mszkowalik/SamplingScope/Project Outputs for Sampling_Scope/BOM/BOM-Sampling_Scope(JLCPCB).xlsx

Part Number | Description | Designator | Quantity | Supplier 1 | Manufacturer 1 | Manufacturer Part Number 1 | Manufacturer Lifecycle 1 | Supplier Unit Price 1 | Supplier Subtotal 1 | Manufacturer | Manufacturer Part Number | Price | Revision State | Supplier Currency 1 | Supplier Order Qty 1 | Supplier Part Number 1 | Supplier Stock 1 | Supplier Subtotal per Board 1 | Footprint
C_1NF_50V_C0G_0402_5 | Ceramic Capacitor | C8_COMP_N, C8_COMP_P, C23_DELAY_DAC1, C23_DELAY_DAC2, C23_VREF_DAC1, C23_VREF_DAC2, C81_VREF_N, C81_VREF_P, C95 | 9 | Digi-Key | Taiyo Yuden | UMK105CG102JV-F | Not Recommended for New Design | 0.091 | 0.91 | Taiyo Yuden | UMK105CG102JV-F | 0.91 | Not managed | USD | 10 | 587-5484-6-ND | 7189 | 0.819 | C_0402_1005
C_1UF_25V_X5R_0402_10 | Ceramic Capacitor | C5_COMP_N, C5_COMP_P, C72, C108, C109 | 5 | Mouser | Samsung | CL05A105KA5NQNC | Volume Production | 0.089 | 0.89 | Samsung Electro-Mechanics | CL05A105KA5NQNC | 0.89 | Not managed | USD | 10 | 187-CL05A105KA5NQNC | 106632 | 0.445 | C_0402_1005
C_4U7F_10V_X5R_0402_20 | Ceramic Capacitor | C39, C40 | 2 | Mouser | Samsung | CL05A475MP5NRNC | Volume Production |  |  | Samsung Electro-Mechanics | CL05A475MP5NRNC |  | Not managed |  |  | 187-CL05A475MP5NRNC |  |  | C_0402_1005
C_10UF_25V_X5R_0805_10 | Ceramic Capacitor | C43, C44, C45_LDO_CMOS, C45_LDO_ECL, C46_LDO_CMOS, C46_LDO_ECL, C49_LDO_CMOS, C49_LDO_ECL, C50_LDO_CMOS, C50_LDO_ECL, C53, C58, C60, C61, C62, C63, C64, C67, C68, C69, C70, C71, C91, C92, C93, C110 | 26 | Mouser | Samsung | CL21A106KAYNNNE | Volume Production | 0.085 | 2.21 | Samsung Electro-Mechanics | CL21A106KAYNNNE | 2.21 | Not managed | USD | 26 | 187-CL21A106KAYNNNE | 1170 | 2.21 | C_0805_2012
C_22UF_25V_X5R_0805_20 | Ceramic Capacitor | C52, C55, C56, C57 | 4 | Mouser | Murata | GRM21BR61E226ME44K | Volume Production | 0.47 | 1.88 | Murata Electronics | GRM21BR61E226ME44K | 1.88 | Not managed | USD | 4 | 81-GRM21BR61E226ME4K | 326239 | 1.88 | C_0805_2012
C_100NF_16V_X5R_0402_10 | Ceramic Capacitor | C1, C2, C3, C4, C6_COMP_N, C6_COMP_P, C7_COMP_N, C7_COMP_P, C9_COMP_N, C9_COMP_P, C10_COMP_N, C10_COMP_P, C11_COMP_N, C11_COMP_P, C12_COMP_N, C12_COMP_P, C13_COMP_N, C13_COMP_P, C14_COMP_N, C14_COMP_P, C15_COMP_N, C15_COMP_P, C16_COMP_N, C16_COMP_P, C17_DELAY_DAC1, C17_DELAY_DAC2, C17_VREF_DAC1, C17_VREF_DAC2, C18_DELAY_DAC1, C18_DELAY_DAC2, C18_VREF_DAC1, C18_VREF_DAC2, C19_DELAY_DAC1, C19_DELAY_DAC2, C19_VREF_DAC1, C19_VREF_DAC2, C20_DELAY_DAC1, C20_DELAY_DAC2, C20_VREF_DAC1, C20_VREF_DAC2, C21_DELAY_DAC1, C21_DELAY_DAC2, C21_VREF_DAC1, C21_VREF_DAC2, C22_DELAY_DAC1, C22_DELAY_DAC2, C22_VREF_DAC1, C22_VREF_DAC2, C24, C25, C26, C27, C29, C30, C31, C32, C33, C34, C35, C36, C37, C47_LDO_CMOS, C47_LDO_ECL, C48_LDO_CMOS, C48_LDO_ECL, C51, C54, C59, C65, C66, C73, C74, C75, C76, C77_PROGRAMMABLE_DELAY_LINE_MAIN, C77_PROGRAMMABLE_DELAY_LINE_STEP_GEN, C78_PROGRAMMABLE_DELAY_LINE_MAIN, C78_PROGRAMMABLE_DELAY_LINE_STEP_GEN, C79_VREF_N, C79_VREF_P, C80_VREF_N, C80_VREF_P, C82, C83, C84, C85, C86, C87, C88, C89, C90, C94, C96, C97, C98, C99, C100, C101, C102, C103, C104, C105, C106, C107, C111, C112, C113, C114, C115, C116, C120, C130 | 112 | Mouser | Taiyo | EMK105BJ104KV-F | Unknown | 0.009 | 1.01 | Taiyo Yuden | EMK105BJ104KV-F | 1.01 | Not managed | USD | 112 | 963-EMK105BJ104KV-F | 2966120 | 1.01 | C_0402_1005
R_0R_0402_1 | Thick Film Resistor | R11_COMP_N, R11_COMP_P, R22, R25_LDO_CMOS, R25_LDO_ECL, R26_LDO_CMOS, R26_LDO_ECL, R44_PROGRAMMABLE_DELAY_LINE_MAIN, R44_PROGRAMMABLE_DELAY_LINE_STEP_GEN, R103 | 10 | Mouser | Yageo | RC0402FR-070RL | Volume Production | 0.01 | 0.1 | Yageo | RC0402FR-070RL | 0.1 | Not managed | USD | 10 | 603-RC0402FR-070RL | 142836 | 0.1 | R_0402_1005
R_0R_0805_1 | Thick Film Resistor | R107 | 1 | Mouser | Yageo | RC0805JR-070RL | Volume Production | 0.1 | 0.1 | Yageo | RC0805JR-070RL | 0.1 | Not managed | USD | 1 | 603-RC0805JR-070RL | 1148965 | 0.1 | R_0805_2012
R_1K5_0402_1 | Thick Film Resistor | R84 | 1 | Mouser | Yageo | RC0402FR-071K5L | Volume Production | 0.1 | 0.1 | Yageo | RC0402FR-071K5L | 0.1 | Not managed | USD | 1 | 603-RC0402FR-071K5L | 394688 | 0.1 | R_0402_1005
R_1K_0402_1 | Thick Film Resistor | R18_DELAY_DAC1, R18_DELAY_DAC2, R18_VREF_DAC1, R18_VREF_DAC2, R19_DELAY_DAC1, R19_DELAY_DAC2, R19_VREF_DAC1, R19_VREF_DAC2, R20_DELAY_DAC1, R20_DELAY_DAC2, R20_VREF_DAC1, R20_VREF_DAC2, R21, R101, R102 | 15 | Mouser | Yageo | RC0402FR-7D1KL | Unknown | 0.012 | 0.18 | Yageo | RC0402FR-7D1KL | 0.18 | Not managed | USD | 15 | 603-RC0402FR-7D1KL | 64382 | 0.18 | R_0402_1005
R_2K_0402_1 | Thick Film Resistor | R45_VREF_N, R45_VREF_P, R46_VREF_N, R46_VREF_P | 4 | Mouser | Yageo | RC0402FR-072KL | Volume Production | 0.012 | 0.12 | Yageo | RC0402FR-072KL | 0.12 | Not managed | USD | 10 | 603-RC0402FR-072KL | 687638 | 0.048 | R_0402_1005
R_4K7_0402_1 | Thick Film Resistor | R110, R111 | 2 | Mouser | Yageo | RC0402FR-7D4K7L | Unknown | 0.012 | 0.12 | Yageo | RC0402FR-7D4K7L | 0.12 | Not managed | USD | 10 | 603-RC0402FR-7D4K7L | 7750 | 0.024 | R_0402_1005
R_10K_0402_1 | Thick Film Resistor | R17_COMP_N, R17_COMP_P, R24, R39, R58, R63, R83, R86, R87, R88, R89, R90, R91, R92, R93, R108, R109_LDO_CMOS, R109_LDO_ECL | 18 | Mouser | Yageo | RC0402FR-7W10KL |  | 0.021 | 0.378 | Yageo | RC0402FR-7W10KL | 0.378 | Not managed | USD | 18 | 603-RC0402FR-7W10KL | 11405 | 0.378 | R_0402_1005
R_22K_0402_1 | Thick Film resistor | R100 | 1 | Mouser | Yageo | RC0402FR-0722KL | Volume Production | 0.1 | 0.1 | Yageo | RC0402FR-0722KL | 0.1 | Not managed | USD | 1 | 603-RC0402FR-0722KL | 201980 | 0.1 | R_0402_1005
R_33R_0402_1 | Thick Film Resistor | R56, R57, R59, R60, R65 | 5 | Mouser | Yageo | RC0402FR-0733RL | Volume Production | 0.014 | 0.14 | Yageo | RC0402FR-0733RL | 0.14 | Not managed | USD | 10 | 603-RC0402FR-0733RL | 1961173 | 0.07 | R_0402_1005
R_49R9_0402_1 | Thick Film Resistor | R66, R67, R68, R69, R70, R71, R72, R73, R74, R75, R76, R77, R78, R79, R80, R81, R82 | 17 | Mouser | Yageo | RC0402FR-0749R9L | Volume Production | 0.012 | 0.204 | Yageo | RC0402FR-0749R9L | 0.204 | Not managed | USD | 17 | 603-RC0402FR-0749R9L | 554069 | 0.204 | R_0402_1005
R_82R5_0402_1 | Thick Film Resistor | R3, R4, R8_COMP_N, R8_COMP_P, R9_COMP_N, R9_COMP_P, R10_COMP_N, R10_COMP_P, R15_COMP_N, R15_COMP_P, R16_COMP_N, R16_COMP_P, R32, R37, R38, R42_PROGRAMMABLE_DELAY_LINE_MAIN, R42_PROGRAMMABLE_DELAY_LINE_STEP_GEN, R43_PROGRAMMABLE_DELAY_LINE_MAIN, R43_PROGRAMMABLE_DELAY_LINE_STEP_GEN, R52, R53, R54, R55, R96, R97 | 25 | Mouser | Yageo | RC0402FR-0782R5L | Volume Production | 0.014 | 0.35 | Yageo | RC0402FR-0782R5L | 0.35 | Not managed | USD | 25 | 603-RC0402FR-0782R5L | 14880 | 0.35 | R_0402_1005
R_100K_0402_1 | Thick Film Resistor | R28, R85, R98, R104, R105, R106 | 6 | Mouser | Yageo | RC0402FR-07100KL | Volume Production | 0.012 | 0.12 | Yageo | RC0402FR-07100KL | 0.12 | Not managed | USD | 10 | 603-RC0402FR-07100KL | 1854795 | 0.072 | R_0402_1005
R_100R_0402_1 | Thick Film Resistor | R23, R99 | 2 | Mouser | Yageo | RC0402FR-13100RL | Volume Production | 0.012 | 0.12 | Yageo | RC0402FR-13100RL | 0.12 | Not managed | USD | 10 | 603-RC0402FR-13100RL | 521264 | 0.024 | R_0402_1005
R_127R_0402_1 | Thick Film Resistor | R1, R2, R5_COMP_N, R5_COMP_P, R6_COMP_N, R6_COMP_P, R7_COMP_N, R7_COMP_P, R12_COMP_N, R12_COMP_P, R13_COMP_N, R13_COMP_P, R31, R35, R36, R40_PROGRAMMABLE_DELAY_LINE_MAIN, R40_PROGRAMMABLE_DELAY_LINE_STEP_GEN, R41_PROGRAMMABLE_DELAY_LINE_MAIN, R41_PROGRAMMABLE_DELAY_LINE_STEP_GEN, R48, R49, R50, R51, R94, R95 | 25 | Mouser | Yageo | RC0402FR-07127RL | Volume Production | 0.016 | 0.4 | Yageo | RC0402FR-07127RL | 0.4 | Not managed | USD | 25 | 603-RC0402FR-07127RL | 29867 | 0.4 | R_0402_1005
R_150R_0402_1 | Thick Film Resistor | R61, R62, R64 | 3 | Mouser | Yageo | RC0402FR-07150RL | Volume Production | 0.012 | 0.12 | Yageo | RC0402FR-07150RL | 0.12 | Not managed | USD | 10 | 603-RC0402FR-07150RL | 397690 | 0.036 | R_0402_1005
R_200K_0402_1 | Thick Film Resistor | R27 | 1 | Mouser | Yageo | RC0402FR-07200KL | Volume Production | 0.1 | 0.1 | Yageo | RC0402FR-07200KL | 0.1 | Not managed | USD | 1 | 603-RC0402FR-07200KL | 706297 | 0.1 | R_0402_1005
