mszkowalik/SamplingScope/Project Outputs for Sampling_Scope/BOM/BOM-Sampling_Scope(NO JLCPCB).xlsx

Part Number | Description | Designator | Sample | Quantity | Manufacturer 1 | Manufacturer Part Number 1 | Supplier 1 | Supplier Part Number 1 | Supplier Unit Price 1 | Supplier Subtotal 1
744231091 | Common Mode Line Filter | L8 | 0 | 1
60312202111527 | SMA Connector | CLK_OUT1, COMP_IN_N1, COMP_IN_P1, DUT_N1, DUT_P1, SNS_N1, SNS_P1, TRIGGER1 | 0 | 8
ADCMP582BCPZ-RL7 | Single Comparator | U4_COMP_N, U4_COMP_P, U15 | 2 | 3
PS1608GT2-R50-T1 | 20GHz Resistive Power Splitter | PS1, PS2 | 0 | 2
632723100011 | WR-COM USB 3.1 Type C Receptacle Horizontal THT / SMT | J3 | 0 | 1
SN74AHC1G04DBVR | Inverters Single | U7_COMP_N, U7_COMP_P, U10, U24 | 5 | 4
EVQ-P7J01P | Tact Switch | S1 | 0 | 1 | Panasonic | EVQ-P7J01P | Digi-Key | P16767CT-ND | 0.28 | 0.28
74HC4040BQX | 12 bit binary ripple counter | U23 | 0 | 1 | NXP Semiconductors | 74HC4040BQX | Mouser | 771-74HC4040BQX | 0.51 | 0.51
74LVC1G17SE-7 | Schmitt Buffer | U3 | 0 | 1 | Diodes | 74LVC1G17SE-7 | Mouser | 621-74LVC1G17SE-7 | 0.27 | 0.27
74LVC1G79GV,125 | D Flip Flop Positive Edge Trigger | U6_COMP_N, U6_COMP_P | 0 | 2 | Nexperia | 74LVC1G79GV,125 | Mouser | 771-LVC1G79GV125 | 0.38 | 0.76
74LVC161PW,112 | 4 bit Counter with preset | U22 | 0 | 1 | NXP Semiconductors | 74LVC161PW112 | Mouser | 771-LVC161PW112
1239AS-H-4R7M=P2 | Power Inductor | L1, L2, L4, L5, L6, L7 | 0 | 6 | Murata | 1239AS-H-4R7M=P2 | Mouser | 81-1239AS-H-4R7MP2 | 0.43 | 2.58
C_8P2F_50V_C0G_0402_3 | Ceramic Capacitor | C41, C42 | 0 | 2 | Taiyo Yuden | UMK105CG8R2DV-F | Mouser | 963-UMK105CG8R2DV-F | 0.016 | 0.16
DRV8850RGYR | Low Voltage H-Bridge IC With LDO Voltage Regulator | U25 | 5 | 1 | Texas Instruments | DRV8850RGYR | Mouser | 595-DRV8850RGYR | 1.61 | 1.61
ESDA25P35-1U1M | High power transient voltage suppressor | D2 | 0 | 1 | STMicroelectronics | ESDA25P35-1U1M | Mouser | 511-ESDA25P35-1U1M | 0.45 | 0.45
ESDA25W | TVS DIODE 24VWM SOT23 | D3 | 0 | 1 | STMicroelectronics | ESDA25W | Mouser | 511-ESDA25W | 0.42 | 0.42
FBMJ1608HS220NTR | Ferrite Bead | FB2, FB3 | 0 | 2 | Taiyo Yuden | FBMJ1608HS220NTR | Mouser | 963-FBMJ1608HS220NTR | 0.1 | 0.2
FTSH-105-01-L-DV-K-TR | CONN HEADER SMD 10POS 1.27MM | STM1 | 0 | 1 | Samtec | FTSH-105-01-L-DV-K-TR | Mouser | 200-FTSH10501LDVKTR | 3 | 3
MC100EPT21MNR4G | Differential LVPECL/LVDS/CML to LVTTL/LVCMOS Translator | U2, U5_COMP_N, U5_COMP_P | 0 | 3 | ON Semiconductor | MC100EPT21MNR4G | Mouser | 863-MC100EPT21MNR4G | 10.08 | 30.24
MC100LVELT20DG | LVTTL/LVCMOS to Differential LVPECL Translator | U1 | 0 | 1 | ON Semiconductor | MC100LVELT20DG | Mouser | 863-MC100LVELT20DG | 4.63 | 4.63
MCP1501-20E/SN | 2.048V Voltage References Precision Buffered Voltage Reference | U8_DELAY_DAC1, U8_DELAY_DAC2, U8_VREF_DAC1, U8_VREF_DAC2 | 3 | 4 | Microchip | MCP1501-20E/SN | Mouser | 579-MCP1501-20E/SN | 0.82 | 3.28
MCP4921-E/SN | 1 Channel DAC 12 bit | U9_DELAY_DAC1, U9_DELAY_DAC2, U9_VREF_DAC1, U9_VREF_DAC2 | 4 | 4 | Microchip | MCP4921-E/SN | Mouser | 579-MCP4921-E/SN | 2.07 | 8.28
MLZ2012M2R2HT000 | Ferrite Bead | FB1 | 0 | 1 | TDK | MLZ2012M2R2HT000 | Mouser | 810-MLZ2012M2R2HT000 | 0.14 | 0.14
NCP15XH103J03RC | NTC Thermistor | RT1, RT2, RT3, RT4 | 0 | 4 | Murata | NCP15XH103J03RC | Mouser | 81-NCP15XH103J03RC | 0.1 | 0.4
NCV8705MT33TCG | Low Dropout, Ultra-Low Iq, High PSRR, Ultra-Low Noise 3.3V | U12_LDO_CMOS, U12_LDO_ECL, U13_LDO_CMOS, U13_LDO_ECL | 0 | 4 | ON Semiconductor | NCV8705MT33TCG | Mouser | 863-NCV8705MT33TCG | 1.35 | 5.4
OPA197IDR | Single Precision Rail-to-Rail Input Outpu Low Offset Voltage Op Amp | U17_VREF_N, U17_VREF_P | 5 | 2 | Texas Instruments | OPA197IDR | Mouser | 595-OPA197IDR | 1.65 | 3.3
R_18K7_0402_1 | Thick Film Resistor | R30 | 0 | 1 | Yageo | RC0402FR-0718K7L | Mouser | 603-RC0402FR-0718K7L | 0.1 | 0.1
R_24R9_0402_1 | Thick Film Resistor | R14_COMP_N, R14_COMP_P | 0 | 2 | Yageo | RC0402FR-0724R9L | Mouser | 603-RC0402FR-0724R9L | 0.014 | 0.14
R_30K_0402_1 | Thick Film Resistor | R29 | 0 | 1 | Yageo | RC0402FR-0730KL | Mouser | 603-RC0402FR-0730KL | 0.1 | 0.1
R_82K_0402_1 | Thisk Film Resistor | R47_VREF_N, R47_VREF_P | 0 | 2 | Yageo | RC0402FR-0782KL | Mouser | 603-RC0402FR-0782KL | 0.012 | 0.12
R_750R_0402_1 | Thick Film Resistor | R33, R34 | 0 | 2 | Yageo | RC0402FR-07750RL | Mouser | 603-RC0402FR-07750RL | 0.012 | 0.12
Si53360-B-GT | Low Jitter Clock Buffer | U20, U21 | 2 | 2 | Silicon Labs | SI53360-B-GT | Mouser | 634-SI53360-B-GT | 1.38 | 2.76
SMAJ5.0A-13-F | ESD Suppressors / TVS Diodes | D1 | 0 | 1 | Diodes | SMAJ5.0A-13-F | Mouser | 621-SMAJ5.0A-13-F | 0.39 | 0.39
STL6P3LLH6 | P-MOSFET 30V 6A 24mOhm | Q2, Q3 | 0 | 2 | STMicroelectronics | STL6P3LLH6 | Mouser | 511-STL6P3LLH6 | 0.99 | 1.98
STM32H733ZGT6 | MCU, 32 Bit, Cortex M7 RISC 1MB Flash 144 LQFP | U28 | 0 | 1 | STMicroelectronics | STM32H733ZGT6 | Mouser | 511-STM32H733ZGT6
STUSB4500QTR | Standalone USB PD controller for power sinking devices | U27 | 0 | 1 | STMicroelectronics | STUSB4500QTR | Mouser | 511-STUSB4500QTR | 2.25 | 2.25
SY10EP11UZG | 1:2 PECL Fanout Buffer | U18, U19, U26 | 0 | 3 | Microchip | SY10EP11UZG | Mouser | 998-SY10EP11UZG | 4.91 | 14.73
SY89296UMG | Delay Lines/Timing Elements 2.5V/3.3V PECL Delay Line | U16_PROGRAMMABLE_DELAY_LINE_MAIN, U16_PROGRAMMABLE_DELAY_LINE_STEP_GEN | 0 | 2 | Microchip | SY89296UMG | Mouser | 998-SY89296UMG | 11.48 | 22.96
TPD1E05U06DPYR | 1 Channel ESD Protection Device for Super-Speed (Up to 6 Gbps) | D4, D5 | 0 | 2 | Texas Instruments | TPD1E05U06DPYR | Mouser | 595-TPD1E05U06DPYR | 0.49 | 0.98
TPD4E05U06DQAR | ESD Suppressors / TVS Diodes 4Chnl U-Lo Capacitnc IEC ESD Prot Diodes | U11 | 0 | 1 | Texas Instruments | TPD4E05U06DQAR | Mouser | 595-TPD4E05U06DQAR | 0.65 | 0.65
TPS54308DDCR | FCCM SYNCHRONOUS STEP DOWN CONVE | U14 | 5 | 1 | Texas Instruments | TPS54308DDCR | Mouser | 595-TPS54308DDCR | 1.68 | 1.68
TPS65133DPDR | Split-Rail Converter, ±5V, 250mA Dual Output Power Supply | Q1 | 5 | 1 | Texas Instruments | TPS65133DPDR | Mouser | 595-TPS65133DPDR | 2.61 | 2.61
TSX-3225 24.0000MF20G-AC | Resonator Ceramic | XT1 | 0 | 1 | Epson | TSX-322524.0000MF20G-AC0 | Mouser | 732-322524F20GAC0 | 0.34 | 0.34
74438357056 | Power Inductor | L3 | 0 | 1 |  |  | Wurth electronics | 74438357056
691101710002 | PCB Terminal Block 1x2 | J2 | 0 | 1 |  |  | Wurth Elektronik | 691101710002
