mszkowalik/SamplingScope/Project Outputs for Sampling_Scope/BOM/JLCPCB_BOM-Sampling_Scope(JLCPCB).xlsx

Part Number | Description | Designator | Footprint | Manufacturer 2 | Manufacturer Part Number 2 | Supplier 2 | Supplier Part Number 2
R_4K7_0402_1 | Thick Film Resistor | R111 | R_0402_1005
R_4K7_0402_1 | Thick Film Resistor | R110 | R_0402_1005
R_10K_0402_1 | Thick Film Resistor | R109_LDO_ECL | R_0402_1005 | Uniroyal Elec | 0402WGF1002TCE | LCSC | C25744
R_10K_0402_1 | Thick Film Resistor | R109_LDO_CMOS | R_0402_1005 | Uniroyal Elec | 0402WGF1002TCE | LCSC | C25744
R_10K_0402_1 | Thick Film Resistor | R108 | R_0402_1005 | Uniroyal Elec | 0402WGF1002TCE | LCSC | C25744
R_0R_0805_1 | Thick Film Resistor | R107 | R_0805_2012 | Uniroyal Elec | 0805W8F0000T5E | LCSC | C17477
R_100K_0402_1 | Thick Film Resistor | R106 | R_0402_1005 | Uniroyal Elec | 0402WGF1003TCE | LCSC | C25741
R_100K_0402_1 | Thick Film Resistor | R105 | R_0402_1005 | Uniroyal Elec | 0402WGF1003TCE | LCSC | C25741
R_100K_0402_1 | Thick Film Resistor | R104 | R_0402_1005 | Uniroyal Elec | 0402WGF1003TCE | LCSC | C25741
R_0R_0402_1 | Thick Film Resistor | R103 | R_0402_1005 | Uniroyal Elec | 0402WGF0000TCE | LCSC | C17168
R_1K_0402_1 | Thick Film Resistor | R102 | R_0402_1005 | Uniroyal Elec | 0402WGF1001TCE | LCSC | C11702
R_1K_0402_1 | Thick Film Resistor | R101 | R_0402_1005 | Uniroyal Elec | 0402WGF1001TCE | LCSC | C11702
R_22K_0402_1 | Thick Film resistor | R100 | R_0402_1005 | Uniroyal Elec | 0402WGF2202TCE | LCSC | C25768
R_100R_0402_1 | Thick Film Resistor | R99 | R_0402_1005 | Uniroyal Elec | 0402WGF1000TCE | LCSC | C25076
R_100K_0402_1 | Thick Film Resistor | R98 | R_0402_1005 | Uniroyal Elec | 0402WGF1003TCE | LCSC | C25741
R_82R5_0402_1 | Thick Film Resistor | R97 | R_0402_1005 | Uniroyal Elec | 0402WGF825JTCE | LCSC | C52037
R_82R5_0402_1 | Thick Film Resistor | R96 | R_0402_1005 | Uniroyal Elec | 0402WGF825JTCE | LCSC | C52037
R_127R_0402_1 | Thick Film Resistor | R95 | R_0402_1005 | Uniroyal Elec | 0402WGF1270TCE | LCSC | C247127
R_127R_0402_1 | Thick Film Resistor | R94 | R_0402_1005 | Uniroyal Elec | 0402WGF1270TCE | LCSC | C247127
R_10K_0402_1 | Thick Film Resistor | R93 | R_0402_1005 | Uniroyal Elec | 0402WGF1002TCE | LCSC | C25744
R_10K_0402_1 | Thick Film Resistor | R92 | R_0402_1005 | Uniroyal Elec | 0402WGF1002TCE | LCSC | C25744
R_10K_0402_1 | Thick Film Resistor | R91 | R_0402_1005 | Uniroyal Elec | 0402WGF1002TCE | LCSC | C25744
R_10K_0402_1 | Thick Film Resistor | R90 | R_0402_1005 | Uniroyal Elec | 0402WGF1002TCE | LCSC | C25744
R_10K_0402_1 | Thick Film Resistor | R89 | R_0402_1005 | Uniroyal Elec | 0402WGF1002TCE | LCSC | C25744
R_10K_0402_1 | Thick Film Resistor | R88 | R_0402_1005 | Uniroyal Elec | 0402WGF1002TCE | LCSC | C25744
R_10K_0402_1 | Thick Film Resistor | R87 | R_0402_1005 | Uniroyal Elec | 0402WGF1002TCE | LCSC | C25744
R_10K_0402_1 | Thick Film Resistor | R86 | R_0402_1005 | Uniroyal Elec | 0402WGF1002TCE | LCSC | C25744
R_100K_0402_1 | Thick Film Resistor | R85 | R_0402_1005 | Uniroyal Elec | 0402WGF1003TCE | LCSC | C25741
R_1K5_0402_1 | Thick Film Resistor | R84 | R_0402_1005 | Uniroyal Elec | 0402WGF1501TCE | LCSC | C25867
R_10K_0402_1 | Thick Film Resistor | R83 | R_0402_1005 | Uniroyal Elec | 0402WGF1002TCE | LCSC | C25744
R_49R9_0402_1 | Thick Film Resistor | R82 | R_0402_1005 | Uniroyal Elec | 0402WGF499JTCE | LCSC | C25120
R_49R9_0402_1 | Thick Film Resistor | R81 | R_0402_1005 | Uniroyal Elec | 0402WGF499JTCE | LCSC | C25120
R_49R9_0402_1 | Thick Film Resistor | R80 | R_0402_1005 | Uniroyal Elec | 0402WGF499JTCE | LCSC | C25120
R_49R9_0402_1 | Thick Film Resistor | R79 | R_0402_1005 | Uniroyal Elec | 0402WGF499JTCE | LCSC | C25120
R_49R9_0402_1 | Thick Film Resistor | R78 | R_0402_1005 | Uniroyal Elec | 0402WGF499JTCE | LCSC | C25120
R_49R9_0402_1 | Thick Film Resistor | R77 | R_0402_1005 | Uniroyal Elec | 0402WGF499JTCE | LCSC | C25120
R_49R9_0402_1 | Thick Film Resistor | R76 | R_0402_1005 | Uniroyal Elec | 0402WGF499JTCE | LCSC | C25120
R_49R9_0402_1 | Thick Film Resistor | R75 | R_0402_1005 | Uniroyal Elec | 0402WGF499JTCE | LCSC | C25120
R_49R9_0402_1 | Thick Film Resistor | R74 | R_0402_1005 | Uniroyal Elec | 0402WGF499JTCE | LCSC | C25120
R_49R9_0402_1 | Thick Film Resistor | R73 | R_0402_1005 | Uniroyal Elec | 0402WGF499JTCE | LCSC | C25120
R_49R9_0402_1 | Thick Film Resistor | R72 | R_0402_1005 | Uniroyal Elec | 0402WGF499JTCE | LCSC | C25120
R_49R9_0402_1 | Thick Film Resistor | R71 | R_0402_1005 | Uniroyal Elec | 0402WGF499JTCE | LCSC | C25120
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
C_100NF_16V_X5R_0402_10 | Ceramic Capacitor | C97 | C_0402_1005 | Samsung Electro-Mechanics | CL05B104KO5NNNC | LCSC | C1525
C_100NF_16V_X5R_0402_10 | Ceramic Capacitor | C96 | C_0402_1005 | Samsung Electro-Mechanics | CL05B104KO5NNNC | LCSC | C1525
C_1NF_50V_C0G_0402_5 | Ceramic Capacitor | C95 | C_0402_1005 | Guangdong Fenghua Advanced Tech | 0402B102K500NT | LCSC | C1523
C_100NF_16V_X5R_0402_10 | Ceramic Capacitor | C94 | C_0402_1005 | Samsung Electro-Mechanics | CL05B104KO5NNNC | LCSC | C1525
C_10UF_25V_X5R_0805_10 | Ceramic Capacitor | C93 | C_0805_2012 | Samsung Electro-Mechanics | CL21A106KAYNNNE | LCSC | C15850
C_10UF_25V_X5R_0805_10 | Ceramic Capacitor | C92 | C_0805_2012 | Samsung Electro-Mechanics | CL21A106KAYNNNE | LCSC | C15850
C_10UF_25V_X5R_0805_10 | Ceramic Capacitor | C91 | C_0805_2012 | Samsung Electro-Mechanics | CL21A106KAYNNNE | LCSC | C15850
C_100NF_16V_X5R_0402_10 | Ceramic Capacitor | C90 | C_0402_1005 | Samsung Electro-Mechanics | CL05B104KO5NNNC | LCSC | C1525
C_100NF_16V_X5R_0402_10 | Ceramic Capacitor | C89 | C_0402_1005 | Samsung Electro-Mechanics | CL05B104KO5NNNC | LCSC | C1525
C_100NF_16V_X5R_0402_10 | Ceramic Capacitor | C88 | C_0402_1005 | Samsung Electro-Mechanics | CL05B104KO5NNNC | LCSC | C1525
C_100NF_16V_X5R_0402_10 | Ceramic Capacitor | C87 | C_0402_1005 | Samsung Electro-Mechanics | CL05B104KO5NNNC | LCSC | C1525
C_100NF_16V_X5R_0402_10 | Ceramic Capacitor | C86 | C_0402_1005 | Samsung Electro-Mechanics | CL05B104KO5NNNC | LCSC | C1525
C_100NF_16V_X5R_0402_10 | Ceramic Capacitor | C85 | C_0402_1005 | Samsung Electro-Mechanics | CL05B104KO5NNNC | LCSC | C1525
C_100NF_16V_X5R_0402_10 | Ceramic Capacitor | C84 | C_0402_1005 | Samsung Electro-Mechanics | CL05B104KO5NNNC | LCSC | C1525
C_100NF_16V_X5R_0402_10 | Ceramic Capacitor | C83 | C_0402_1005 | Samsung Electro-Mechanics | CL05B104KO5NNNC | LCSC | C1525
C_100NF_16V_X5R_0402_10 | Ceramic Capacitor | C82 | C_0402_1005 | Samsung Electro-Mechanics | CL05B104KO5NNNC | LCSC | C1525
C_1NF_50V_C0G_0402_5 | Ceramic Capacitor | C81_VREF_P | C_0402_1005 | Guangdong Fenghua Advanced Tech | 0402B102K500NT | LCSC | C1523
C_1NF_50V_C0G_0402_5 | Ceramic Capacitor | C81_VREF_N | C_0402_1005 | Guangdong Fenghua Advanced Tech | 0402B102K500NT | LCSC | C1523
C_100NF_16V_X5R_0402_10 | Ceramic Capacitor | C80_VREF_P | C_0402_1005 | Samsung Electro-Mechanics | CL05B104KO5NNNC | LCSC | C1525
C_100NF_16V_X5R_0402_10 | Ceramic Capacitor | C80_VREF_N | C_0402_1005 | Samsung Electro-Mechanics | CL05B104KO5NNNC | LCSC | C1525
C_100NF_16V_X5R_0402_10 | Ceramic Capacitor | C79_VREF_P | C_0402_1005 | Samsung Electro-Mechanics | CL05B104KO5NNNC | LCSC | C1525
C_100NF_16V_X5R_0402_10 | Ceramic Capacitor | C79_VREF_N | C_0402_1005 | Samsung Electro-Mechanics | CL05B104KO5NNNC | LCSC | C1525
C_100NF_16V_X5R_0402_10 | Ceramic Capacitor | C78_PROGRAMMABLE_DELAY_LINE_STEP_GEN | C_0402_1005 | Samsung Electro-Mechanics | CL05B104KO5NNNC | LCSC | C1525
C_100NF_16V_X5R_0402_10 | Ceramic Capacitor | C78_PROGRAMMABLE_DELAY_LINE_MAIN | C_0402_1005 | Samsung Electro-Mechanics | CL05B104KO5NNNC | LCSC | C1525
C_100NF_16V_X5R_0402_10 | Ceramic Capacitor | C77_PROGRAMMABLE_DELAY_LINE_STEP_GEN | C_0402_1005 | Samsung Electro-Mechanics | CL05B104KO5NNNC | LCSC | C1525
C_100NF_16V_X5R_0402_10 | Ceramic Capacitor | C77_PROGRAMMABLE_DELAY_LINE_MAIN | C_0402_1005 | Samsung Electro-Mechanics | CL05B104KO5NNNC | LCSC | C1525
C_100NF_16V_X5R_0402_10 | Ceramic Capacitor | C76 | C_0402_1005 | Samsung Electro-Mechanics | CL05B104KO5NNNC | LCSC | C1525
C_100NF_16V_X5R_0402_10 | Ceramic Capacitor | C75 | C_0402_1005 | Samsung Electro-Mechanics | CL05B104KO5NNNC | LCSC | C1525
C_100NF_16V_X5R_0402_10 | Ceramic Capacitor | C74 | C_0402_1005 | Samsung Electro-Mechanics | CL05B104KO5NNNC | LCSC | C1525
C_100NF_16V_X5R_0402_10 | Ceramic Capacitor | C73 | C_0402_1005 | Samsung Electro-Mechanics | CL05B104KO5NNNC | LCSC | C1525
C_1UF_25V_X5R_0402_10 | Ceramic Capacitor | C72 | C_0402_1005 | Samsung Electro-Mechanics | CL05A105KA5NQNC | LCSC | C52923
C_10UF_25V_X5R_0805_10 | Ceramic Capacitor | C71 | C_0805_2012 | Samsung Electro-Mechanics | CL21A106KAYNNNE | LCSC | C15850
C_10UF_25V_X5R_0805_10 | Ceramic Capacitor | C70 | C_0805_2012 | Samsung Electro-Mechanics | CL21A106KAYNNNE | LCSC | C15850
C_10UF_25V_X5R_0805_10 | Ceramic Capacitor | C69 | C_0805_2012 | Samsung Electro-Mechanics | CL21A106KAYNNNE | LCSC | C15850
C_10UF_25V_X5R_0805_10 | Ceramic Capacitor | C68 | C_0805_2012 | Samsung Electro-Mechanics | CL21A106KAYNNNE | LCSC | C15850
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
C_100NF_16V_X5R_0402_10 | Ceramic Capacitor | C2 | C_0402_1005 | Samsung Electro-Mechanics | CL05B104KO5NNNC | LCSC | C1525
C_100NF_16V_X5R_0402_10 | Ceramic Capacitor | C1 | C_0402_1005 | Samsung Electro-Mechanics | CL05B104KO5NNNC | LCSC | C1525
