mszkowalik/SamplingScope/Measurements/DAC_Delay.csv

8 | 1.949320882488340000E-08
16 | 1.949267414147470000E-08
24 | 1.949220873598280000E-08
32 | 1.949158345837530000E-08
40 | 1.949083916485960000E-08
48 | 1.949042705007290000E-08
56 | 1.949026895431420000E-08
64 | 1.949002026435660000E-08
72 | 1.948476402446890000E-08
80 | 1.948810179897010000E-08
88 | 1.948796857220710000E-08
96 | 1.948696137787920000E-08
104 | 1.948627392778230000E-08
112 | 1.948552608155300000E-08
120 | 1.948494698922330000E-08
128 | 1.948391137318590000E-08
136 | 1.948298589127260000E-08
144 | 1.947883099262530000E-08
152 | 1.948223093961590000E-08
160 | 1.948169270349350000E-08
168 | 1.948110828209340000E-08
176 | 1.948063577117410000E-08
184 | 1.948011529862010000E-08
192 | 1.947947936287160000E-08
200 | 1.947907080079860000E-08
208 | 1.947821282044520000E-08
216 | 1.947742944707900000E-08
224 | 1.947443273309090000E-08
232 | 1.947599592710960000E-08
240 | 1.947541150570940000E-08
248 | 1.947465122498220000E-08
256 | 1.947406325086830000E-08
264 | 1.947364758336790000E-08
272 | 1.947280559022600000E-08
280 | 1.947224248510790000E-08
288 | 1.947199557150730000E-08
296 | 1.947179484318440000E-08
304 | 1.947073080543760000E-08
312 | 1.946863648072390000E-08
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
