mszkowalik/SamplingScope/Measurements/DAC_Delay.xlsx

Sheet: _Com COM10_ (2021-04-30_232414)
Column1.1 | Column1.3 | Column1.5 | Column1.6 | Column1.7 | Column1.8 | Column1.9 | Column1.10 | Column1.11 | Column1.12 | Column1.13
0 |  |  |  |  |  |  |  | 1.946624906e-08
8 | 1.948500028e-08 | 1.948591155e-08 | 1.949360851e-08 | 1.949171669e-08 | 1.946677486e-08 | 1.949320882e-08 | 1.946306405e-08 | 1.946566286e-08 | 1.947264039e-08 | 1.948063577e-08
16 | 1.948551009e-08 | 1.94861407e-08 | 1.949321771e-08 | 1.949262085e-08 | 1.94658476e-08 | 1.949267414e-08 | 1.946271944e-08 | 1.946458994e-08 | 1.947228334e-08 | 1.947974404e-08
24 | 1.948535733e-08 | 1.948609452e-08 | 1.949275585e-08 | 1.949422312e-08 | 1.946527739e-08 | 1.949220874e-08 | 1.946168915e-08 | 1.946114203e-08 | 1.947203998e-08 | 1.947942074e-08
32 | 1.948494877e-08 | 1.948535377e-08 | 1.949213235e-08 | 1.949346462e-08 | 1.946198758e-08 | 1.949158346e-08 | 1.946128236e-08 | 1.946412098e-08 | 1.947159056e-08 | 1.947886652e-08
40 | 1.948453843e-08 | 1.948495409e-08 | 1.949121042e-08 | 1.94928873e-08 | 1.946240147e-08 | 1.949083916e-08 | 1.946084716e-08 | 1.94633536e-08 | 1.947040751e-08 | 1.947811867e-08
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
