mszkowalik/SamplingScope/Sampling_Scope.pdf

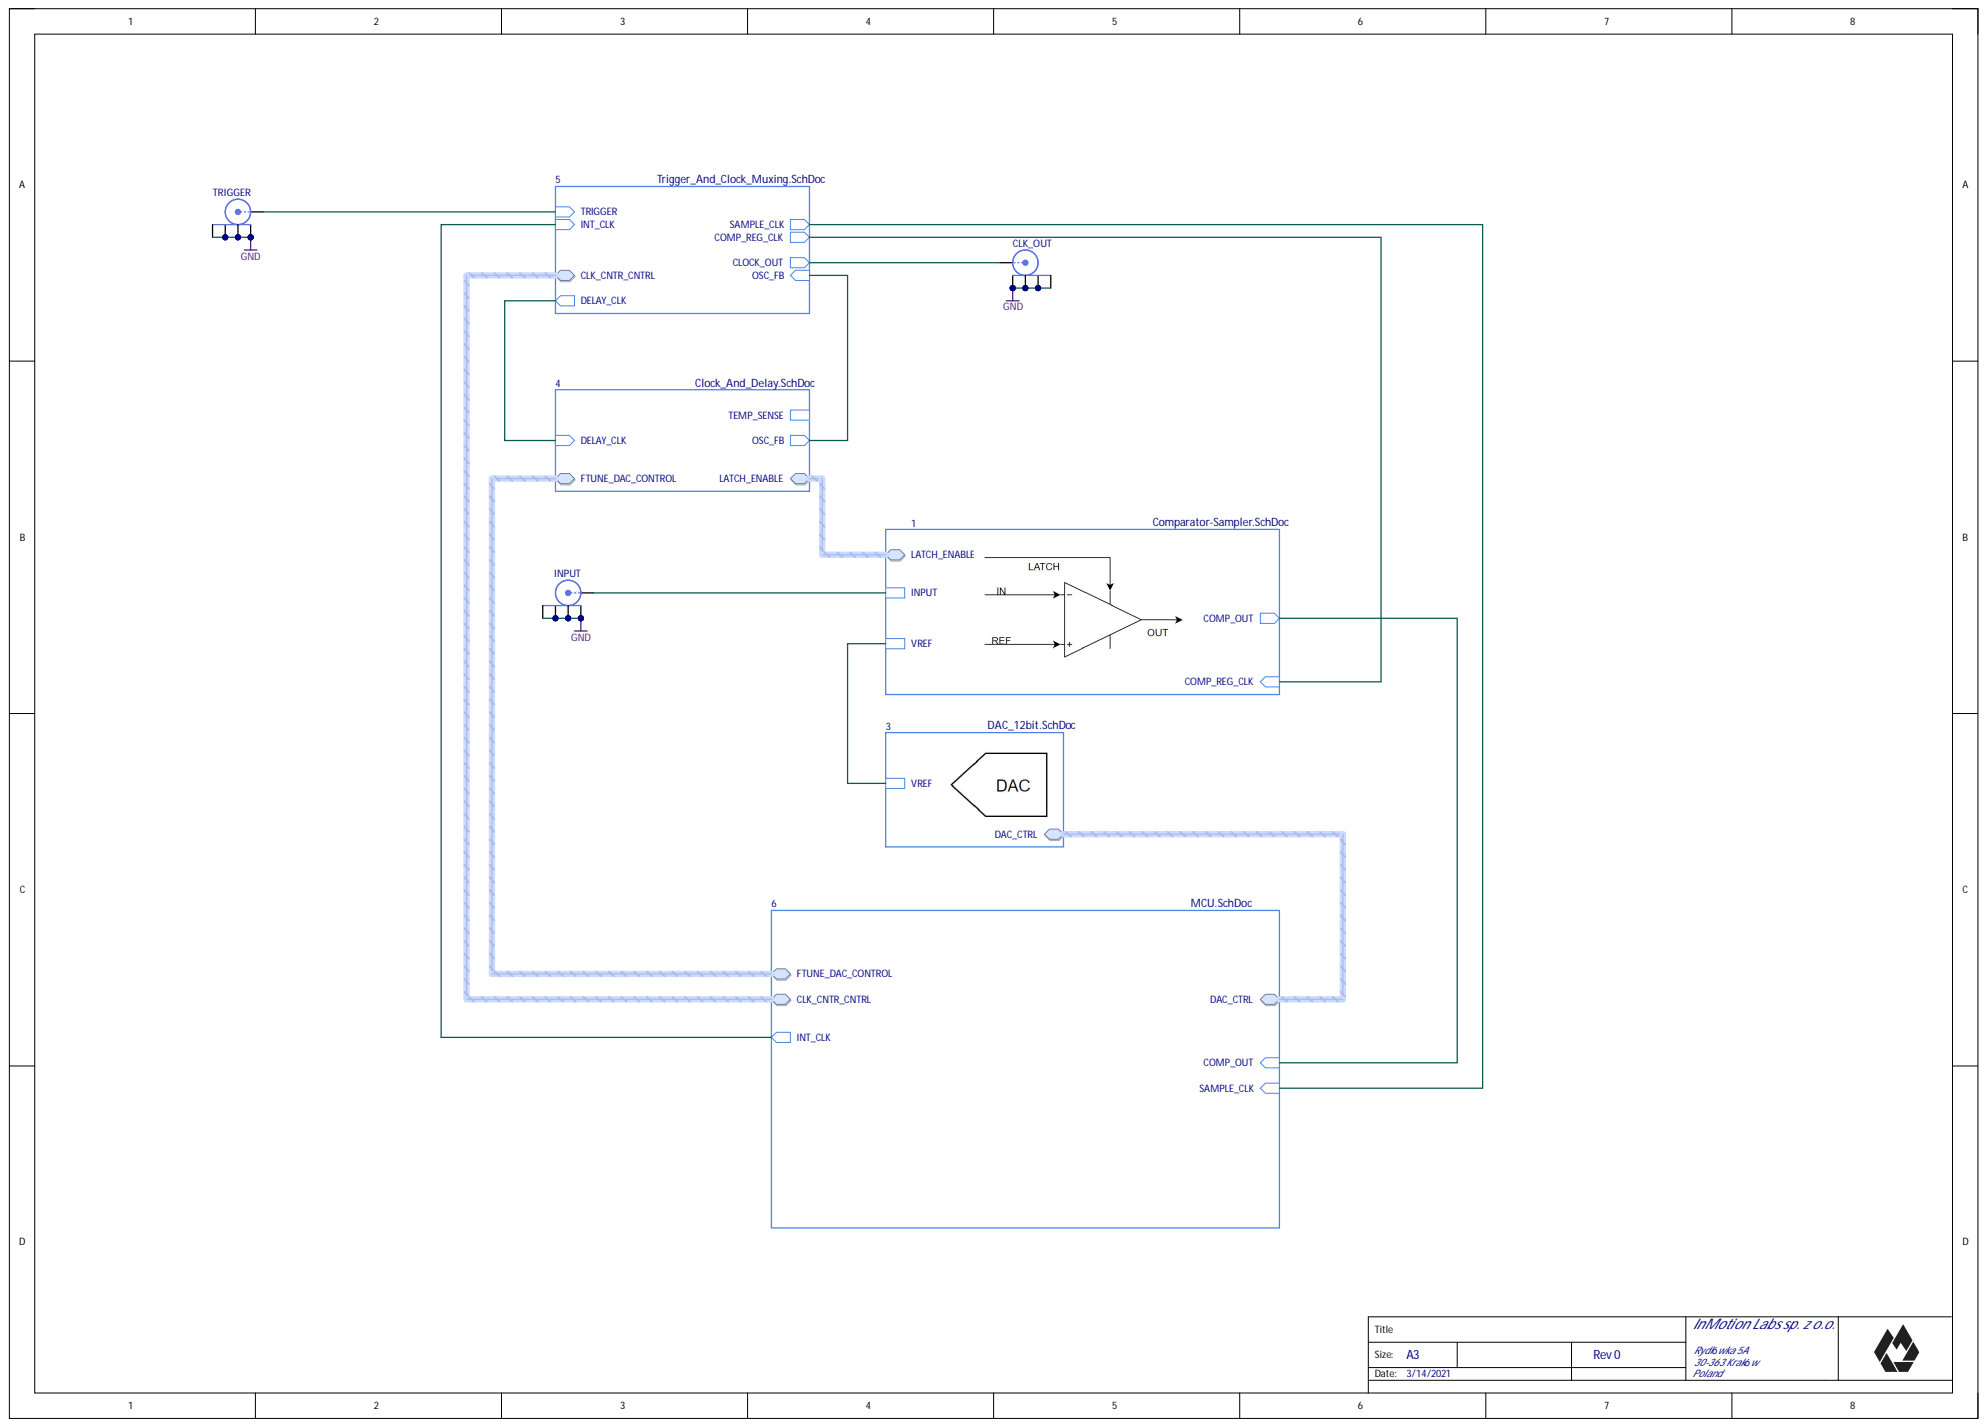
[picture p1: page 1]

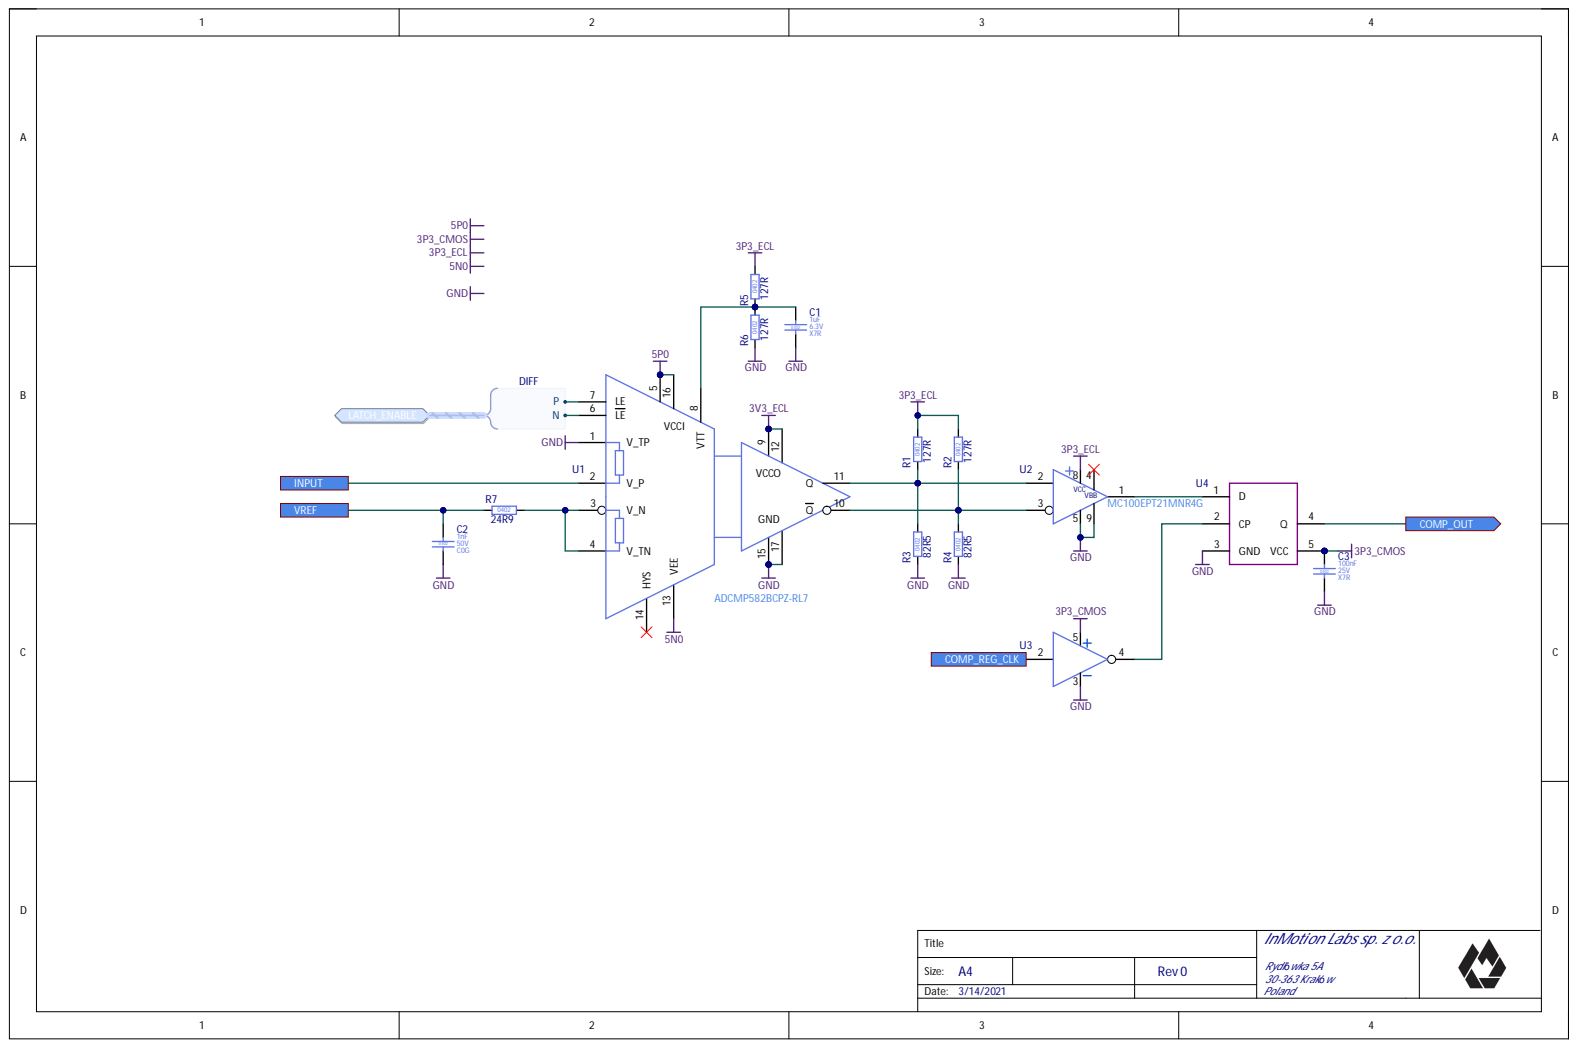
[picture p2: page 2]

VREF | 0402 | 4

Ti t l e | InMot ion Labs sp. z o.o. Rydl ó wka 5A 30-363 Krakó w Polan d

A4 S i ze : | | Rev 0

Date : 3/1 4/2021

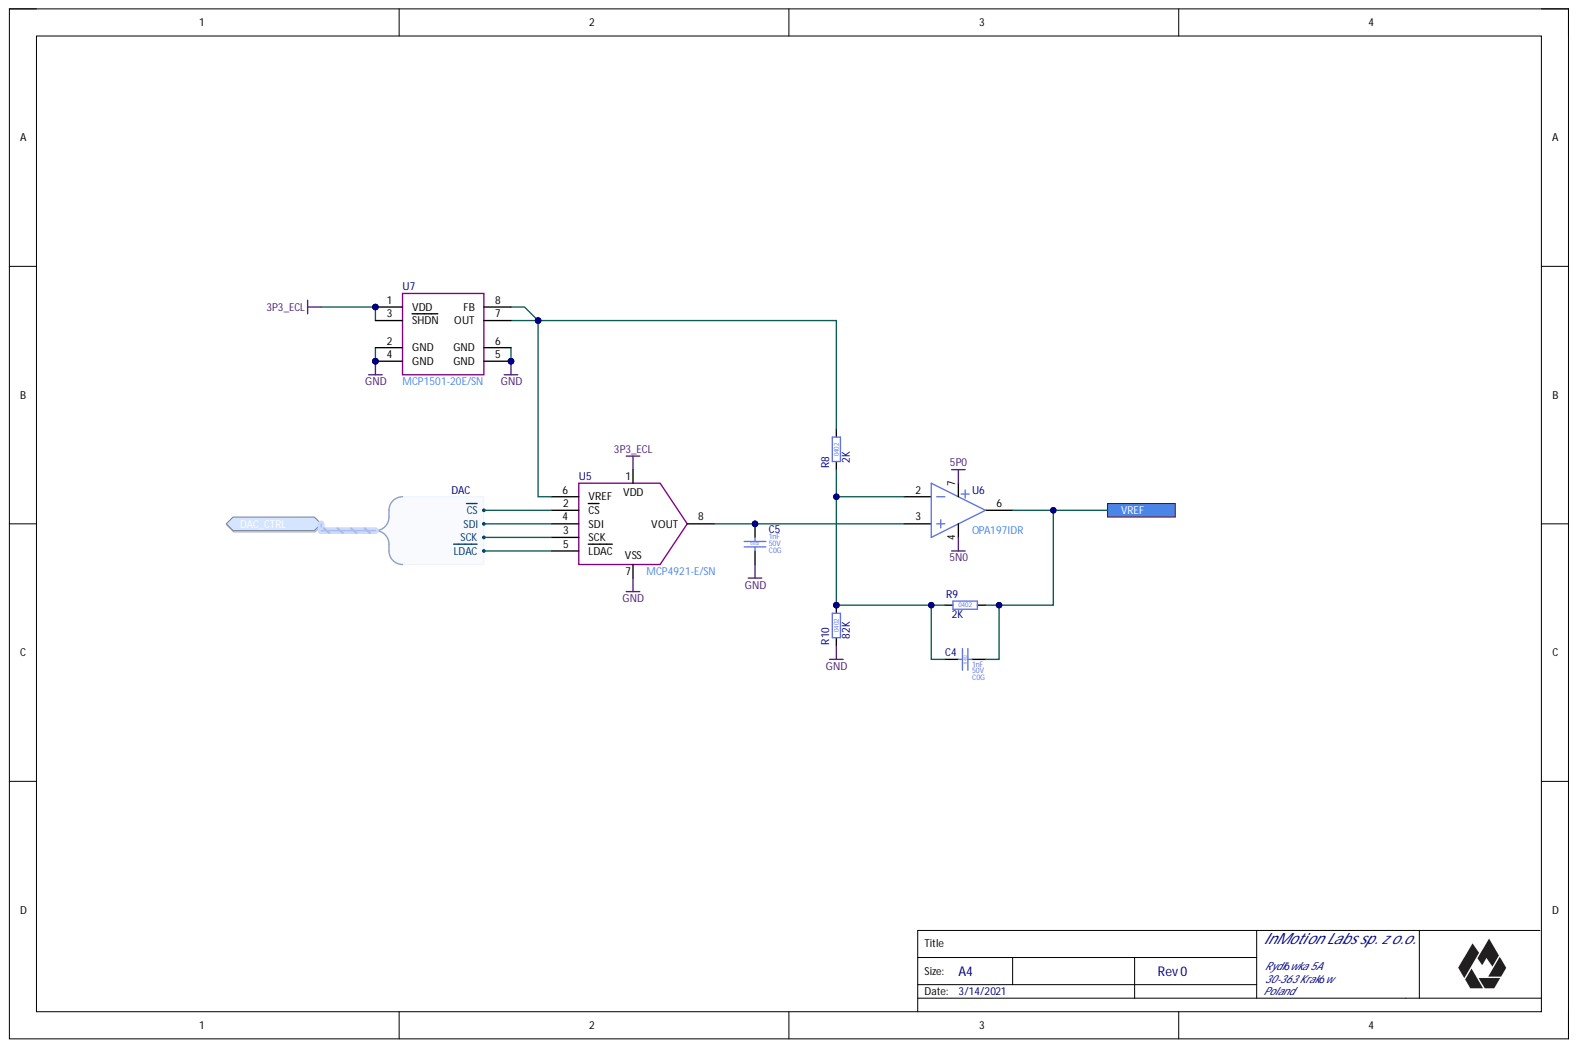
[picture p3: page 3]

Title | InMotion Labs sp. z o.o. Rydlówka 5A 30-363 Kraków Poland

A4 Size: | | Rev 0

Date: 3/14/2021

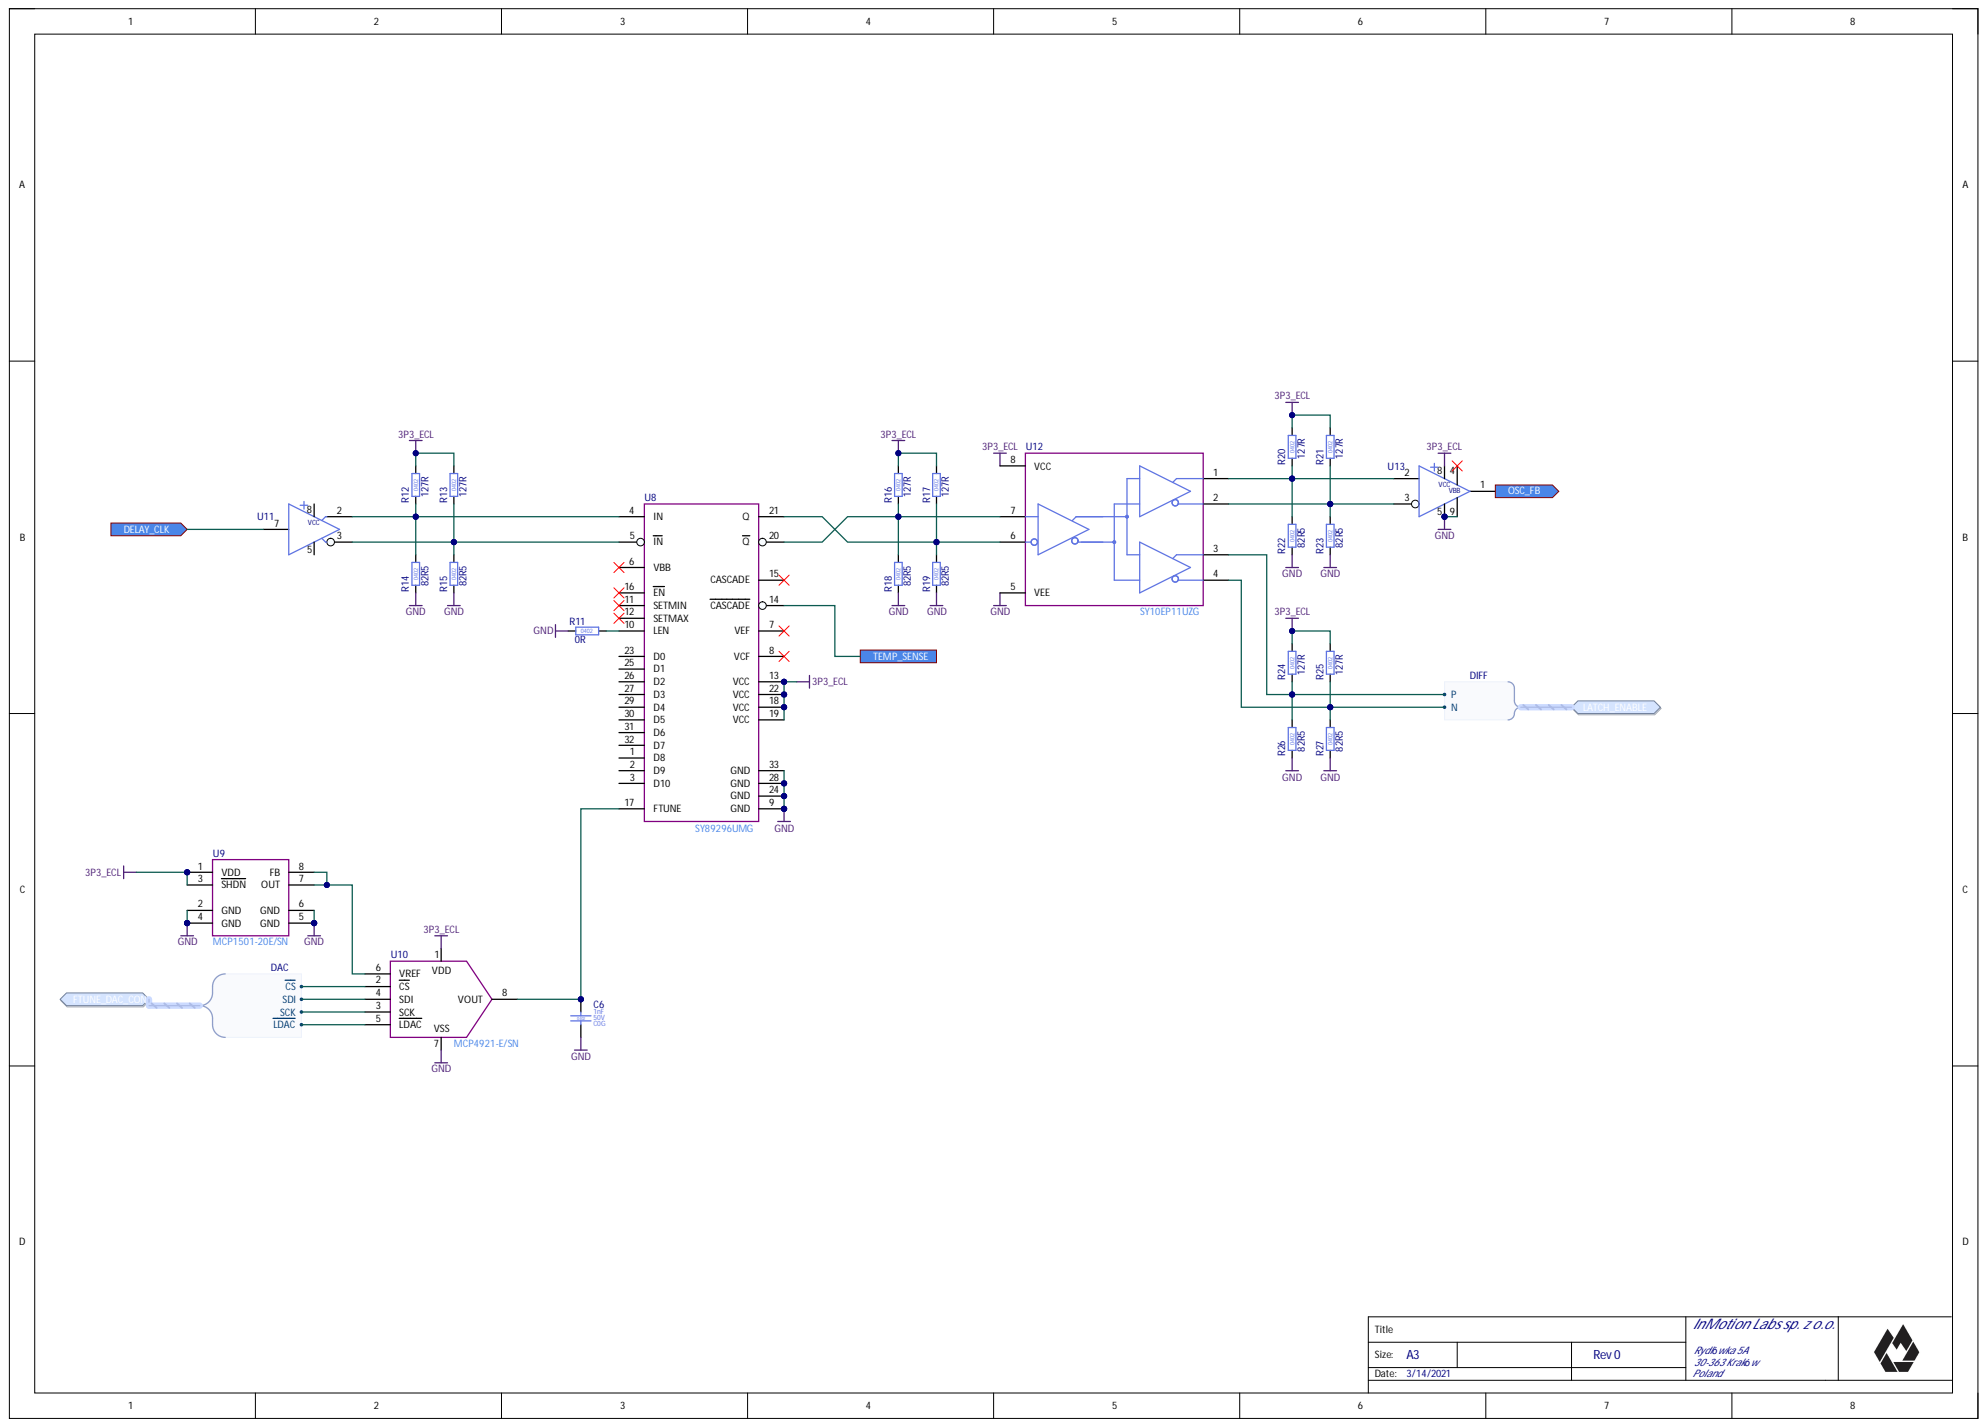
[picture p4: page 4]

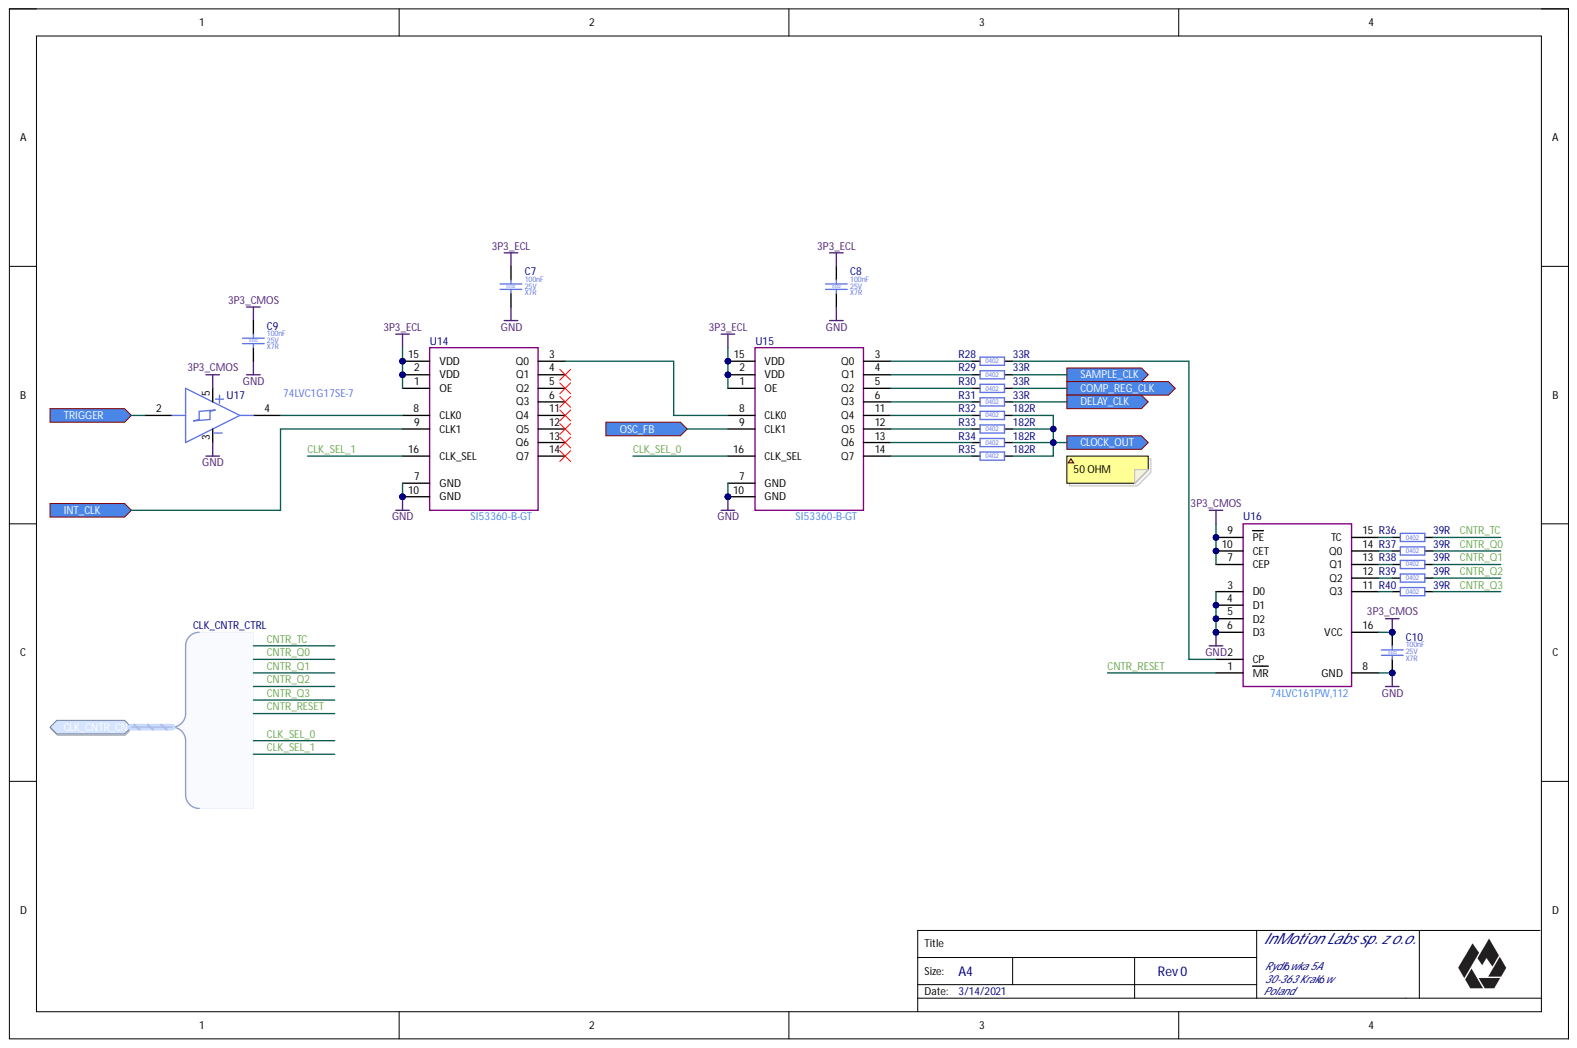
[picture p5: page 5]
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

A4 S i ze : | | Rev 0

Date : 3/1 4/2021

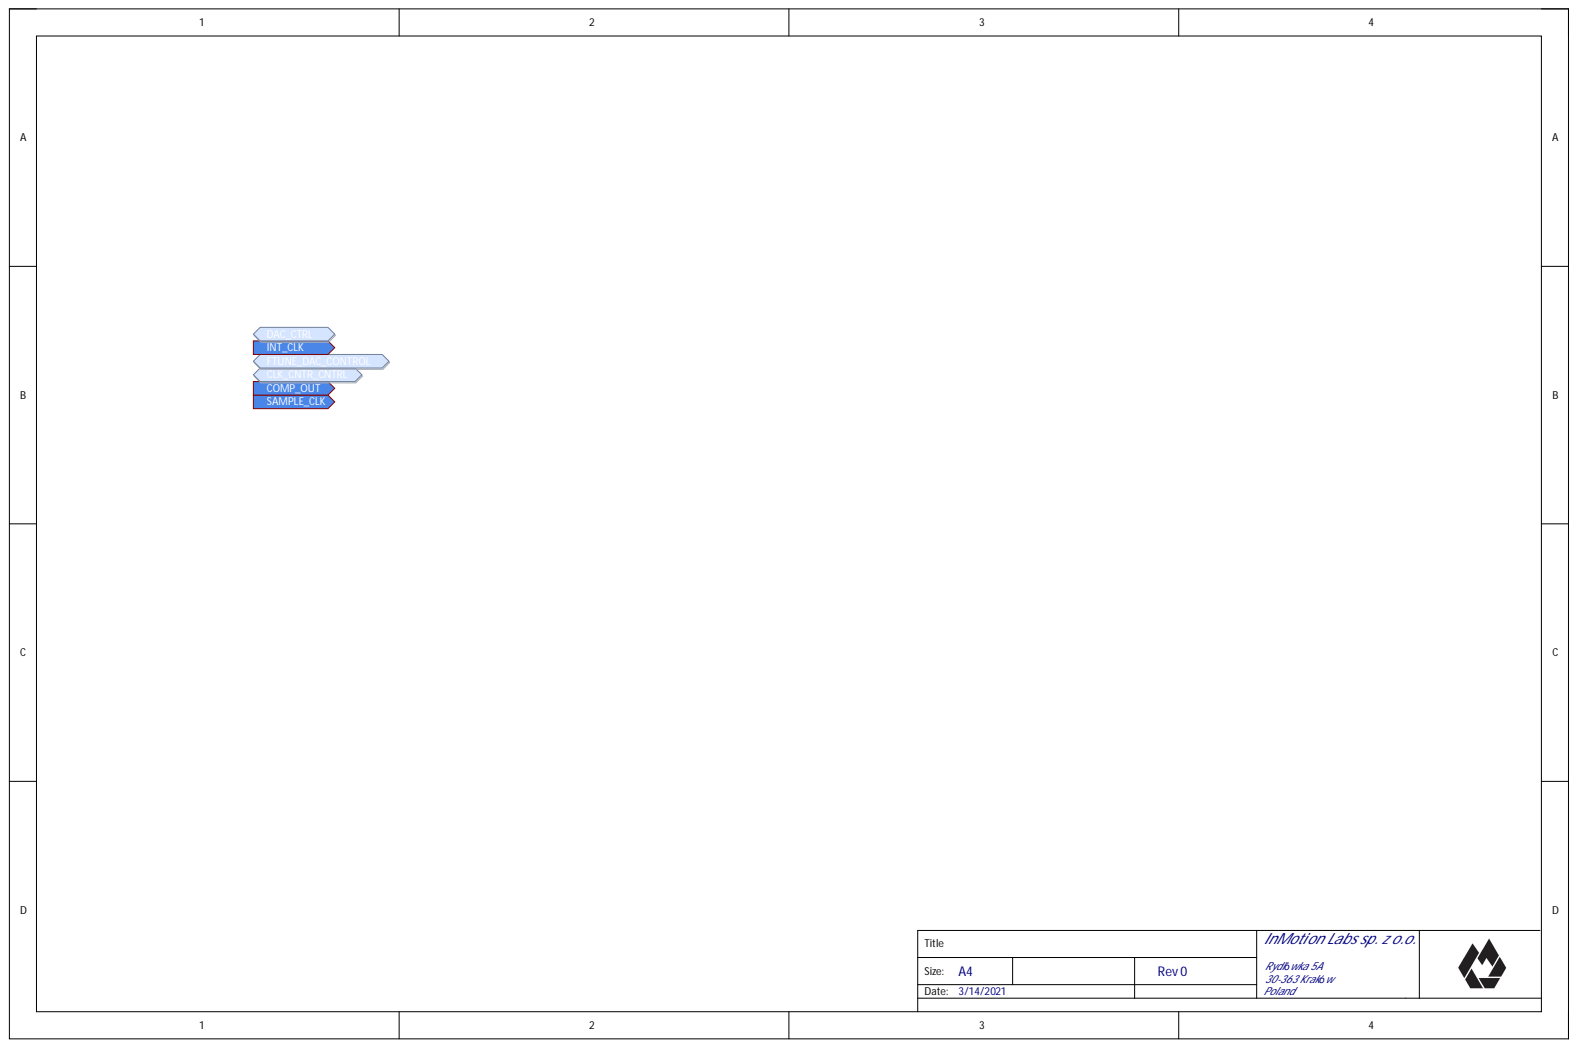
[picture p6: page 6]

Title | InMotion Labs sp. z o.o. Rydlówka 5A 30-363 Kraków Poland

A4 Size: | | Rev 0

Date: 3/14/2021
