mszkowalik/SamplingScope/(list of files, drawings)

Other design files:
3V3_LDO.SchDoc
3V8_SWITCHER.SchDoc
CMOS_MUX.SchDoc
Comparator-Sampler.SchDoc
Counter.SchDoc
DAC_12bit.SchDoc
ECL_Fanout_X2.SchDoc
ECL_Fanout_X3.SchDoc
Fixed_Delay_Line.SchDoc
Main.SchDoc
MCU.SchDoc
POWER.SchDoc
Programmable_Delay_Line.SchDoc
Sampling_Scope.PrjPcb
Sampling_Scope_Panel.PcbDoc
SIMO_SWITCHER.SchDoc
Step_Gen.SchDoc
Thermal_MGMT.SchDoc
USB_C_PD.SchDoc
VREF.SchDoc
