mszkowalik/SamplingScope/Firmware/Firmware/Core/Src/main.cpp

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
/* Includes ------------------------------------------------------------------*/
#include "main.h"
#include "usb_device.h"

/* USER CODE BEGIN Includes */

#include "../SamplingScope.h"
#include "usbd_cdc_if.h"
#include "../CLI/CLI.h"
#include <stdlib.h>
#include "usbd_cdc_if.h"
/* USER CODE END Includes */

/* USER CODE BEGIN PD */
  #define ADC_CONVERTED_DATA_BUFFER_SIZE   ((uint32_t)  8)   /* Size of array aADCxConvertedData[] */
/* USER CODE END PD */

ADC_HandleTypeDef hadc1;
DMA_HandleTypeDef hdma_adc1;

I2C_HandleTypeDef hi2c1;

SPI_HandleTypeDef hspi1;
SPI_HandleTypeDef hspi2;
SPI_HandleTypeDef hspi3;
SPI_HandleTypeDef hspi4;

TIM_HandleTypeDef htim24;

/* USER CODE BEGIN PV */

cli_status_t help_func(int argc, char **argv);
cli_status_t measureDelay(int argc, char** argv);
void user_CDC_println(char *string);
/* USER CODE END PV */

void SystemClock_Config(void);
void PeriphCommonClock_Config(void);
static void MX_GPIO_Init(void);
static void MX_DMA_Init(void);
static void MX_ADC1_Init(void);
static void MX_I2C1_Init(void);
static void MX_SPI1_Init(void);
static void MX_SPI2_Init(void);
static void MX_SPI3_Init(void);
static void MX_SPI4_Init(void);
static void MX_TIM24_Init(void);
/* USER CODE BEGIN 0 */

SamplingScope *scope;
CLI *cli;

uint32_t ADC_DATA[ADC_CONVERTED_DATA_BUFFER_SIZE] __attribute__((section(".ram1section")))=
{0};
/* USER CODE END 0 */

/**
  * @brief  The application entry point.
  * @retval int
  */
int main(void)
{
  /* Enable I-Cache---------------------------------------------------------*/
  SCB_EnableICache();

  /* Enable D-Cache---------------------------------------------------------*/
  SCB_EnableDCache();

  /* MCU Configuration--------------------------------------------------------*/

  /* Reset of all peripherals, Initializes the Flash interface and the Systick. */
  HAL_Init();

  /* Configure the system clock */
  SystemClock_Config();

/* Configure the peripherals common clocks */
  PeriphCommonClock_Config();

  /* Initialize all configured peripherals */
  MX_GPIO_Init();
  MX_DMA_Init();
  MX_ADC1_Init();
  MX_I2C1_Init();
  MX_SPI1_Init();
  MX_SPI2_Init();
  MX_SPI3_Init();
  MX_SPI4_Init();
  MX_USB_DEVICE_Init();
  MX_TIM24_Init();
  /* USER CODE BEGIN 2 */

  if (HAL_ADC_Start_DMA(&hadc1, (uint32_t *)ADC_DATA, ADC_CONVERTED_DATA_BUFFER_SIZE) != HAL_OK)
   {
     Error_Handler();
   }
  /* USER CODE END 2 */

  /* Infinite loop */
  /* USER CODE BEGIN WHILE */
  const uint16_t start=0;
 // const uint64_t stop = 0x7FFFFF;

//  const uint64_t stop = 0x7FFFFF;
  const uint64_t stop = 4095;

  cmd_t cmd_tbl[] = {
      {
          .cmd = "help",
          .func = help_func
      },
	  {
			  .cmd = "measureDelay",
			  .func = measureDelay
	  }
  };

  HAL_Delay(1000); // give time for USB CDC to enumerate
  cli = new CLI(&user_CDC_println);

  cli->cmd_tbl = cmd_tbl;
  cli->cmd_cnt = sizeof(cmd_tbl)/sizeof(cmd_t);

  scope = new SamplingScope(&hspi1, &hspi2, &hspi3, &hspi3, &htim24, ADC_DATA);
  while (1)
  {
      //cli->process();
	  //scope->idle();
    /* USER CODE END WHILE */

    /* USER CODE BEGIN 3 */


	  float avg = 0.0;
	  const uint16_t reps=1024;
	  uint32_t r= 0;
	  for(uint32_t j=start; j <= stop; j+=8)
	  {
		  avg = 0.0;
		  for(uint16_t i=0; i < reps; i++)
		  {
			  avg+= scope->measureDelay(j);
		  }
		  avg /= reps;
		  r = j;
		  usb_printf("%d, %.16e\n\r", r, avg);
		  HAL_Delay(10);
	  }



  }
  /* USER CODE END 3 */
}

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
/* USER CODE BEGIN 4 */

/**
  * @brief  Conversion complete callback in non-blocking mode
  * @param  hadc: ADC handle
  * @retval None
  */
void HAL_ADC_ConvHalfCpltCallback(ADC_HandleTypeDef* hadc)
{
  /* Invalidate Data Cache to get the updated content of the SRAM on the first half of the ADC converted data buffer: 32 bytes */
  SCB_InvalidateDCache_by_Addr((uint32_t *) &ADC_DATA[0], ADC_CONVERTED_DATA_BUFFER_SIZE);
}

/**
 * @brief  Conversion DMA half-transfer callback in non-blocking mode
 * @param  hadc: ADC handle
 * @retval None
  */
void HAL_ADC_ConvCpltCallback(ADC_HandleTypeDef* hadc)
{
   /* Invalidate Data Cache to get the updated content of the SRAM on the second half of the ADC converted data buffer: 32 bytes */
  SCB_InvalidateDCache_by_Addr((uint32_t *) &ADC_DATA[ADC_CONVERTED_DATA_BUFFER_SIZE/2], ADC_CONVERTED_DATA_BUFFER_SIZE);
}


void HAL_TIM_PeriodElapsedCallback(TIM_HandleTypeDef *htim)
{
    if (htim->Instance == htim24.Instance)
    {
        //HAL_GPIO_TogglePin(GPIOE,INT_CLK_Pin);

    }
}

cli_status_t help_func(int argc, char **argv)
{
	usb_printf("HELP function executed\n\r");
	for (int i = 1; i < argc; i++) {
		usb_printf("%s \n\r",argv[i]);
	    }
	return CLI_OK;
}


cli_status_t measureDelay(int argc, char** argv)
{
	if(argc == 3)
	{
		uint32_t word = atoi(argv[1]);
		uint32_t reps = atoi(argv[2]);
		float ret = 0.0;

		usb_printf("Measuring %d reps of Delay %d \n\r", reps, word);
		for(int i = 0; i < reps; i++){
			ret += scope->measureDelay(word);
		}
		ret = ret/reps;
		usb_printf("Delay [s] : %.16e\n\r", ret);
	}
}
void user_CDC_println(char *string)
{
	usb_printf(string);
}


/* USER CODE END 4 */
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
