mszkowalik/SamplingScope/Firmware/Firmware/Sampling_Scope.ioc

PH0-OSC_IN.Signal=RCC_OSC_IN
PG4.Signal=GPIO_Input
PG8.Signal=GPIO_Output
PC12.Signal=GPIO_Input
PB14.GPIO_Label=VREF1_LDAC
PG6.GPIO_Label=CNTR_Q3
PG0.Signal=GPIO_Output
PA13(JTMS/SWDIO).Signal=DEBUG_JTMS-SWDIO
PC6.GPIO_Label=CNTR_Q0
PA6.GPIO_Label=VREF2_FB
PB13.Signal=GPIO_Output
PG13.Signal=GPIO_Output
PC15-OSC32_OUT.GPIO_Label=ECL_EN
PF6.GPIO_Label=MAIN_DELAY_Q5
PF7.Signal=GPIO_Output
PD4.Signal=GPIO_Input
PB6.Signal=I2C1_SCL
PC7.Signal=GPIO_Input
PD0.Signal=GPIO_Input
PE5.Signal=SPI4_MISO
PF10.GPIO_Label=MAIN_DELAY_Q1
PB2.Signal=SPI3_MOSI
PF1.GPIO_Label=MAIN_DELAY_Q10
PD1.GPIO_Label=CNTR_Q7
PB12.GPIO_Label=VREF2_CS
PF12.GPIO_Label=PD_STEP_FB
PC4.GPIO_Label=RT2
PE9.Signal=GPIO_Output
PB1.GPIO_Label=PD_MAIN_FB
PG4.GPIO_Label=COMP_OUT_N
PE4.GPIO_Label=PROG_DELAY_STEP_GEN_CS
PE2.Signal=SPI4_SCK
PA8.Signal=GPIO_Input
PF3.Signal=GPIO_Output
PE10.Signal=GPIO_Output
PA0.Signal=GPIO_Input
PB1.Signal=ADCx_INP5
PA15(JTDI).GPIO_Label=PROG_DELAY_MAIN_CS
PC3_C.GPIO_Label=USB_PD_RESET
PA10.Signal=GPIO_Input
PE12.GPIO_Label=STEP_GEN_DELAY_Q1
PF14.Signal=GPIO_Output
PE10.GPIO_Label=STEP_GEN_DELAY_Q7
PG12.Signal=GPIO_Output
PG5.Signal=GPIO_Output
PG9.Signal=SPI1_MISO
PC13.Signal=GPIO_Output
PA9.GPIO_Label=CNTR_Q4
PD3.Signal=GPIO_Input
PC6.Signal=GPIO_Input
PB11.GPIO_Label=CLK_EN_1
PD7.Signal=SPI1_MOSI
PD1.Signal=GPIO_Input
PF14.GPIO_Label=STEP_GEN_DELAY_Q9
PC0.Signal=GPIO_Output
PC14-OSC32_IN.Signal=GPIO_Input
PF13.GPIO_Label=STEP_GEN_DELAY_Q10
PG13.GPIO_Label=TM_IN2L
PG10.Signal=GPIO_Output
PF8.GPIO_Label=MAIN_DELAY_Q3
PA8.GPIO_Label=CNTR_Q12
PE8.GPIO_Label=STEP_GEN_DELAY_Q5
PA9.Signal=GPIO_Input
PE9.GPIO_Label=STEP_GEN_DELAY_Q6
PB10.Signal=SPI2_SCK
PB14.Signal=GPIO_Output
PA5.Signal=SPI1_SCK
PE14.Signal=GPIO_Output
PE15.Signal=GPIO_Output
PE8.Signal=GPIO_Output
PG7.GPIO_Label=CNTR_Q2
PF4.GPIO_Label=MAIN_DELAY_Q7
PF13.Signal=GPIO_Output
PG14.GPIO_Label=TM_nSLEEP
PC7.GPIO_Label=CNTR_Q14
PA4.Signal=SPI1_NSS
PE13.GPIO_Label=CLK_SEL_0
PC12.GPIO_Label=CNTR_Q5
PA11.Signal=USB_OTG_HS_DM
PF9.Signal=GPIO_Output
PE3.Signal=GPIO_Output
PA14(JTCK/SWCLK).Signal=DEBUG_JTCK-SWCLK
PF4.Signal=GPIO_Output
PG3.GPIO_Label=CNTR_RESET
PD2.Signal=GPIO_Input
PB0.Signal=ADCx_INP9
PC1.Signal=SPI2_MOSI
PD2.GPIO_Label=CNTR_Q10
PG10.GPIO_Label=TM_IN1H
PG6.Signal=GPIO_Output
Mcu.UserName=STM32H733ZGTx
PG2.Signal=GPIO_Input
PA15(JTDI).Signal=SPI3_NSS
PE11.GPIO_Label=STEP_GEN_DELAY_Q2
PC10.Signal=SPI3_SCK
PA0.GPIO_Label=COMP_OUT_P
PC0.GPIO_Label=MAIN_DELAY_Q0
PD0.GPIO_Label=CNTR_Q6
PB0.GPIO_Label=RT0
PC13.GPIO_Label=VREF2_LDAC
PB13.GPIO_Label=CLK_EN_0
PG5.GPIO_Label=PD_STEP_LDAC
PB11.Signal=GPIO_Output
PG11.Signal=GPIO_Output
PA12.Signal=USB_OTG_HS_DP
PF11.GPIO_Label=VREF1_FB
PF12.Signal=ADC1_INP6
PC2_C.Signal=SPI2_MISO
PE13.Signal=GPIO_Output
PF7.GPIO_Label=MAIN_DELAY_Q4
PF11.Signal=ADC1_INP2
PA10.GPIO_Label=CNTR_Q15
PB7.Signal=I2C1_SDA
PE4.Signal=SPI4_NSS
PA6.Signal=ADCx_INP3
PA2.GPIO_Label=PD_MAIN_LDAC
PF5.GPIO_Label=MAIN_DELAY_Q6
PF8.Signal=GPIO_Output
PG0.GPIO_Label=STEP_GEN_DELAY_Q0
PF5.Signal=GPIO_Output
PC14-OSC32_IN.GPIO_Label=USB_PD_ALERT
PG11.GPIO_Label=TM_IN1L
PC5.Signal=ADCx_INP8
PD3.GPIO_Label=CNTR_Q8
PE7.Signal=GPIO_Output
PF3.GPIO_Label=MAIN_DELAY_Q8
PG2.GPIO_Label=SAMPLE_CLK
PG7.Signal=GPIO_Output
PC9.GPIO_Label=CNTR_Q11
PG3.Signal=GPIO_Output
PG1.Signal=GPIO_Output
PC11.Signal=SPI3_MISO
PC8.Signal=GPIO_Input
PC4.Signal=ADCx_INP4
PE14.GPIO_Label=INT_CLK
PG8.GPIO_Label=CNTR_Q1
PC8.GPIO_Label=CNTR_Q13
PE15.GPIO_Label=CLK_SEL_1
PF6.Signal=GPIO_Output
PF2.Signal=GPIO_Output
PF9.GPIO_Label=MAIN_DELAY_Q2
PE11.Signal=GPIO_Output
PC15-OSC32_OUT.Signal=GPIO_Output
PG14.Signal=GPIO_Output
PG1.GPIO_Label=STEP_GEN_DELAY_Q3
PD4.GPIO_Label=CNTR_Q9
PF10.Signal=GPIO_Output
PH1-OSC_OUT.Signal=RCC_OSC_OUT
PF15.GPIO_Label=STEP_GEN_DELAY_Q8
PF15.Signal=GPIO_Output
PF1.Signal=GPIO_Output
PE6.Signal=SPI4_MOSI
PE7.GPIO_Label=STEP_GEN_DELAY_Q4
PE12.Signal=GPIO_Output
PA2.Signal=GPIO_Output
PA7.GPIO_Label=RT3
PC5.GPIO_Label=RT1
PG12.GPIO_Label=TM_IN2H
PC3_C.Signal=GPIO_Output
PE3.GPIO_Label=SIMO_EN
PC9.Signal=GPIO_Input
PB12.Signal=SPI2_NSS
PA7.Signal=ADCx_INP7
PF2.GPIO_Label=MAIN_DELAY_Q9
