mszkowalik/SamplingScope/(commit log)

2021-03-15 Changed project structure. Hope it's now more readable
    [CMOS_MUX.SchDoc, Clock_And_Delay.SchDoc, Counter.SchDoc, DAC_12bit.SchDoc, Delay_Line.SchDoc, ECL_Fanout.SchDoc, MCU.SchDoc, Main.SchDoc]
2021-03-16 More functionalities, schematic cleanup
    [3V3_LDO.SchDoc, 3V8_SWITCHER.SchDoc, CMOS_MUX.SchDoc, Comparator-Sampler.SchDoc, Delay_Line.SchDoc, ECL_Fanout.SchDoc, ECL_Fanout_X2.SchDoc, ECL_Fanout_X3.SchDoc]
2021-03-18 An idea of board floorplan
    [3V3_LDO.SchDoc, 3V8_SWITCHER.SchDoc, CMOS_MUX.SchDoc, Comparator-Sampler.SchDoc, Counter.SchDoc, DAC_12bit.SchDoc, ECL_Fanout_X2.SchDoc, ECL_Fanout_X3.SchDoc]
2021-03-21 Preliminary Layout - looking for some sensible connections
    [3V3_LDO.SchDoc, 3V8_SWITCHER.SchDoc, CMOS_MUX.SchDoc, Comparator-Sampler.SchDoc, Counter.SchDoc, DAC_12bit.SchDoc, ECL_Fanout_X2.SchDoc, ECL_Fanout_X3.SchDoc]
2021-03-22 More Layout
    [ECL_Fanout_X3.SchDoc, Main.SchDoc, Step_Gen.SchDoc]
2021-03-24 Layout and component data update - passives now can be assemvled by jlcpcb
    [3V3_LDO.SchDoc, 3V8_SWITCHER.SchDoc, CMOS_MUX.SchDoc, Comparator-Sampler.SchDoc, Counter.SchDoc, DAC_12bit.SchDoc, ECL_Fanout_X2.SchDoc, ECL_Fanout_X3.SchDoc]
2021-03-25 Layout and BOM
    [Comparator-Sampler.SchDoc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]
2021-03-31 Added test points, added TVS on USB and prepared for SiWave simulations.
    [CMOS_MUX.SchDoc, Comparator-Sampler.SchDoc, Counter.SchDoc, DAC_12bit.SchDoc, MCU.SchDoc, Main.SchDoc, POWER.SchDoc, Programmable_Delay_Line.SchDoc]
2021-04-06 Files sent to JLCPCB for MFG an ASSY of most passives
    [Counter.SchDoc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]
2021-04-20 BOMs and PDF with schematic
    [BOM-Sampling_Scope(JLCPCB).xlsx, BOM-Sampling_Scope(NO JLCPCB).xlsx, JLCPCB_BOM-Sampling_Scope(JLCPCB).xlsx, Sampling_Scope.PrjPcb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]
2021-04-24 Initial config for Firmware
    [MCU.SchDoc, Sampling_Scope.PrjPcb]
2021-04-24 Corrected pin definitions in IOC file, refactored the code and added more Functionalities to Pin class
    [Pin.cpp, Pin.h]
2021-04-24 corrected IOC file, added read functionality to PinBus class
    [Sampling_Scope.ioc, main.cpp, main.h]
2021-04-25 printing via USB CDC raw delay measurements for delay line calibration
    [MCU.SchDoc]
2021-04-28 In order to enable DMA dor ADC1, there was some fiddling to be made. https://www.programmersought.com/article/9020513531/ With oversampling set to 1024, ADC1 should gain 5 bits of precision; +/- 21 b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
2021-05-02 Attempt to linearize DelayLine characteristics
    [DAC_Delay.csv, DAC_Delay.xlsx, MCU.SchDoc]
