mszkowalik/SamplingScope/(notices)

Notices in the files:
Firmware/Firmware/Core/Src/main.cpp:
© Copyright (c) 2021 STMicroelectronics.
All rights reserved.
This software component is licensed by ST under Ultimate Liberty license
(C) COPYRIGHT STMicroelectronics *****END OF FILE
